erossi/vario/kicad/vario_tiny.sch

## KiCad design kicad/vario_tiny.sch (2017-08-14)

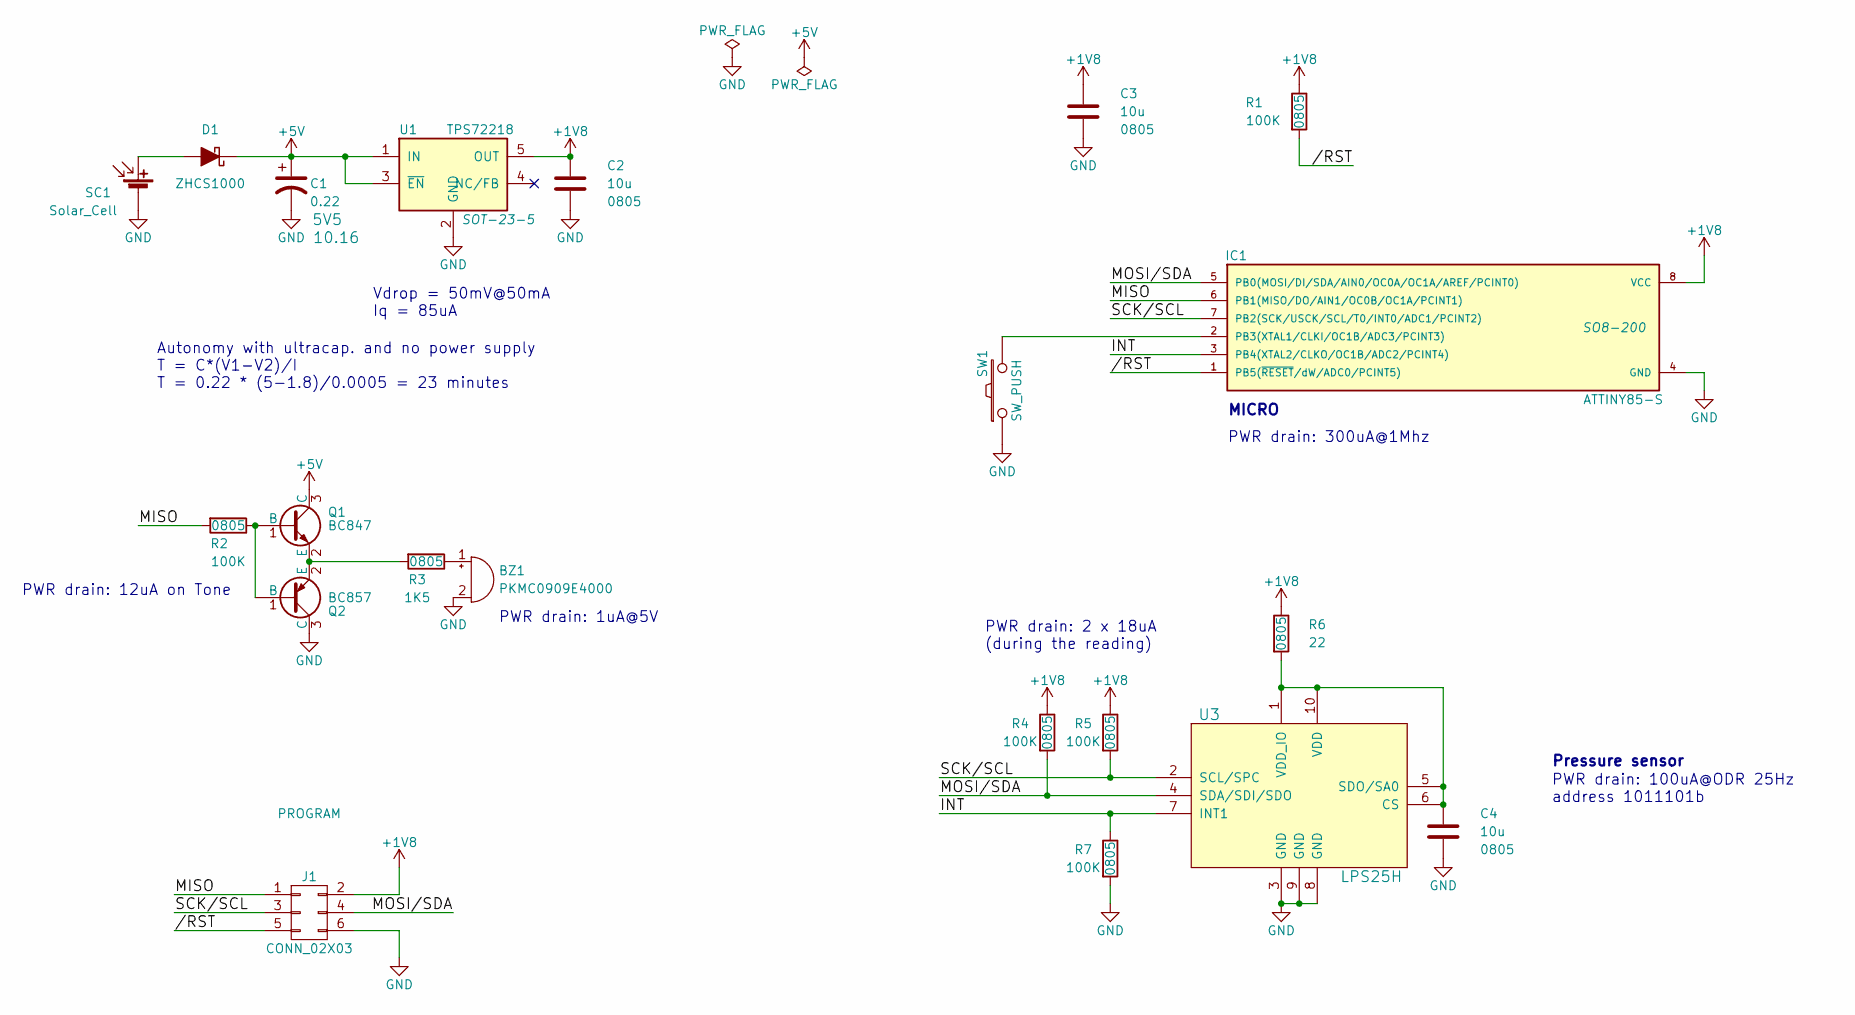
[picture p1: schematic vario_tiny.sch]

Parts:
BZ1: PKMC0909E4000; Buzzer_12x9.5RM7.6
C1: 0.22; voltage 5V5
C2, C3, C4: 10u; 0805
D1: ZHCS1000; SOT-23
IC1: ATTINY85-S; SO8-200
J1: CONN_02X03; PROGRAM
Q1: BC847; SOT-23_Handsoldering
Q2: BC857; SOT-23_Handsoldering
R1, R2, R4, R5, R7: 100K; 0805
R3: 1K5; 0805
R6: 22; 0805
SC1: Solar_Cell
SW1: SW_PUSH
U1: TPS72218; SOT-23-5
U3: LPS25H; HCLGA-10

Connections:
+1V8: C2.1, C3.1, IC1.8 (VCC), J1.2, R1.1, R4.1, R5.1, R6.1, U1.5 (OUT)
+5V: C1.1, D1.1 (K), Q1.3 (C), U1.1 (IN), U1.3 (~EN~)
/RST: IC1.1 (PB5(~RESET~/dW/ADC0/PCINT5)), J1.5, R1.2
GND: BZ1.2 (+), C1.2, C2.2, C3.2, C4.2, IC1.4 (GND), J1.6, Q2.3 (C), R7.2, SC1.2 (-), SW1.1, U1.2 (GND), U3.3 (GND), U3.8 (GND), U3.9 (GND)
INT: IC1.3 (PB4(XTAL2/CLKO/OC1B/ADC2/PCINT4)), R7.1, U3.7 (INT1)
MISO: IC1.6 (PB1(MISO/DO/AIN1/OC0B/OC1A/PCINT1)), J1.1, R2.2
MOSI/SDA: IC1.5 (PB0(MOSI/DI/SDA/AIN0/OC0A/OC1A/AREF/PCI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), J1.4, R4.2, U3.4 (SDA/SDI/SDO)
unnamed: BZ1.1 (-), R3.1
unnamed: C4.1, R6.2, U3.1 (VDD_IO), U3.5 (SDO/SA0), U3.6 (CS), U3.10 (VDD)
unnamed: D1.2 (A), SC1.1 (+)
unnamed: IC1.2 (PB3(XTAL1/CLKI/OC1B/ADC3/PCINT3)), SW1.2
unnamed: Q1.1 (B), Q2.1 (B), R2.1
unnamed: Q1.2 (E), Q2.2 (E), R3.2
SCK/SCL: IC1.7 (PB2(SCK/USCK/SCL/T0/INT0/ADC1/PCINT2)), J1.3, R5.2, U3.2 (SCL/SPC)

Notes on the sheet:
Pressure sensor
Vdrop = 50mV@50mA Iq = 85uA
PWR drain: 300uA@1Mhz
Autonomy with ultracap. and no power supply T = C*(V1-V2)/I T = 0.22 * (5-1.8)/0.0005 = 23 minutes
MICRO
PWR drain: 100uA@ODR 25Hz address 1011101b
PWR drain: 2 x 18uA (during the reading)
PWR drain: 1uA@5V
PWR drain: 12uA on Tone
