erossi/vario/(threads)

Thread 1 (2017-03-14):

bootstrap voltage

erossi, 2017-03-14:
Looks like on boot, the micro start at a lower tension than the lps25 chip, which lead to a failed init of the chip and a non-working system.

erossi, 2017-07-30:
added a watchdog IRQ on 0.4 release, but in case of I2C bus hang, it will (probably) not be enough. Maybe a full reset watchdog is better.
