erossi/vario/(commit log)

2016-01-11 Fix prescaler for the 1Mhz attiny
    * Switch from 16Mhz Arduino to 1Mhz AtTiny
    * duty fixed to 50%
2016-02-18 Added back Arduino device
2016-02-18 imported i2c functions
2016-02-18 test play a fake i2c ok init
    * A fake beep at boot to confirm i2c is ok.
2016-03-10 arduino build by default, fixes
    * default to arduino build.
    * buzz functions moved outside main file.
    * fix i2c prescaler and freq. setup.
    * added lps init function.
    * fixed lps address.
    [buzz.c, buzz.h, i2c.c, lps25.c, lps25.h]
2016-04-15 add temperature and lps25 struct
2016-04-17 add debug/usart and temperature read
    * debug/usart setup for arduino.
    * read temperature from the device, not working.
    [debug.c, debug.h, lps25.c, lps25.h, usart.c, usart.h]
2016-07-25 add multi-register read capabilities
    * Multiple contiguous registers read is now possible.
    * added pressure read.
    * rewritten one-shot sample.
2016-10-10 merge i2c mtm & mrm into mXm
    * with 2nd level of legacy support, mtm and mrm now
    uses mXm with proper address LSB value for READ/WRITE
    operation.
2016-12-19 add USI_TWI from atmel
    * add a 1st test beep main program.
    * split code for arduino.
2016-12-22 swithed to attiny25 and set Makefile
    * The MCU can be switched now from arduino, attiny 25/85.
2016-12-28 fix tiny85 and test ok
    * removed unused i2c_usi, use directed provided USI interface from
    atmel.
    * fix CPU speed i attiny cpu which is 8Mhz by default.
    * add a simple test for USI.
    * fix LPS25 I2C function to work with USI.
    [USI_TWI_Master.h, buzz.c, lps25.c, lps25.h, main_tiny.c, test_usi.c]
2016-12-30 fix I2C to include addr in buffer
    * I2C simplified like the USI functions.
    MxM now takes the address as the 1st byte of the buffer.
    * LPS I2C functions adjusted accordingly.
    * LPS oneshot fixed as per datasheet.
    * main_arduino fixed to test the device and the one shot mode.
    [i2c.c, i2c.h, lps25.c, main_arduino.c]
2017-01-02 fix MSB/LSB in printout and DataRDY IRQ enabled
    * print of the raw value of LSB/MSB fixed.
    * IRQ on data ready enabled.
    [lps25.c, main_arduino.c]
2017-01-02 fix dHpa
    * dHpa is now active and correct.
    [lps25.c]
2017-01-03 add delta-meters test to arduino.
2017-01-03 changed union in lps25 and beep
    * beep() now make sound from 1 to 5 meters.
    * lps25 struct has now unions for Temp and Pressure.
2017-02-14 add 1sec on boot
    * To let the capacitor on the address pins to properly charge.
2017-03-10 arduino usart @115200bps
2017-03-10 simplify the main to target only hPa
    * No need to check for temperature or similar details
    in the main.
2017-03-14 16 samples avg @ 7Hz
    * lps25h does 16 samples with ODR @7Hz
    * main arduino work with some rounding with the new output.
    * tiny version synced.
2017-04-23 force sound to interrupt
    * every 7Hz if the tone is playing stop it, to make the sound
    like a beep and not continuous.
2017-05-03 fix missing define in buzz
    [buzz.h]
2017-06-21 enable IRQ on LPS int
    * pressure fetch from LPS now is an IRQ call.
    * enable sleep, if the IRQ is missed for some reasons,
    sleep forever (BUG).
    [main_tiny.c]
2017-06-23 fix Makefile multiplatform
    * Clean-up some code to better handle arduino, attiny85 and
    attiny85v.
2017-07-30 fix watchdog IRQ on avr-libc
    * Irq watchdog now works with manual configuration.
    * Beep timing is still limited and rigid, 7hz beep long at any rate.
    [main_tiny.c]
2017-08-11 add IRQ for button.
    * Button pressed IRQ function which read the lps.
2017-08-11 moved beep after the IRQ init
    * beep needs IRQ, moved after sei().
    * add IRQ enable for the button.
2017-08-11 fix IRQ button
    * Read the lps instead of the useless delay().
    [main_tiny.c]
2017-08-14 importing kicad files.
    [vario_tiny.sch]
2017-08-14 de-ignore library files
    * add kicad library cache.
